SSL-Roots/Circuit_MotorDriverBoard/MotorDriver作成マニュアル.txt

1.裏面のコンデンサと抵抗をはんだ付けします。
2.裏面のICをはんだ付けします。
3.電源ラインの貫通ビアに抵抗の足などを入れてはんだ付けしてください。
　電流容量を稼ぐためです。
4.表面のコンデンサ、抵抗、ダイオード、LEDをはんだ付けします。
5.表面のICをはんだ付けします。
6.裏面のフレキコネクタをはんだ付けします。
7.4ピンコネクタをはんだ付けします。
8.書き込み用L字ピンヘッダをはんだ付けします。
9.細ピンヘッダをはんだ付けします。
