SSL-Roots/Circuit_MotorDriverBoard/MotorDriver運用マニュアル.txt

使用方法
Roots製メイン基板、エンコーダ基板と組み合わせて使用します。
Roots製メイン基板のピンソケットに挿入して使用します。

エンコーダ基板とのピン配置は以下です。
1:+5V
2:A相信号入力
3:GND
4:B相信号入力

注意点
配線時に確実にメイン基板と同名の信号となるよう配線してください。
逆に接続した場合は破壊の危険があります。
メイン基板へ挿入する場合はピンがズレないように気を付けてください。
ピンがズレた状態で電源を投入すると破壊します。

定格
電源電圧:13V～17V
3.3V:3.3V±0.3V
+5V:5V±0.5V

EC45-flat 30Wにのみ対応します。30W以上のモータの場合破壊する可能性があります。
