SSL-Roots/Circuit_MotorDriverBoard/MotorDriver - MotorDriver.pdf

Part | Value | 耐圧・電力 | Package | 購入先 | 単価
C100 | 10u | 25V | C2012 | 秋月電子 | ¥15.00
C101 | 貫通Co 0.1u | - | CKD610JB | 秋月電子 | ¥20.00
C102 | 0.1u | 25V | C1608 | 秋月電子 | ¥2.00
C103 | 未実装(0.047u) | - | C1608 | - | -
C200 | 1u | 50V | C1608 | 秋月電子 | ¥5.00
C201 | 1u | 50V | C1608 | 秋月電子 | ¥5.00
C202 | 1u | 50V | C1608 | 秋月電子 | ¥5.00
C203 | 1u | 50V | C1608 | 秋月電子 | ¥5.00
C204 | 1u | 50V | C1608 | 秋月電子 | ¥5.00
C205 | 1u | 50V | C1608 | 秋月電子 | ¥5.00
C206 | 100u | 25Ｖ | 5mm | 秋月電子 | ¥10.00
CON100 | 細ピンヘッダ6pin | - | 2.54mmピッチ | 秋月電子 | ¥6.00
CON101 | 細ピンヘッダ6pin | - | 2.54mmピッチ | 秋月電子 | ¥6.00
CON200 | WM10943CT | - | WM10943CT | DigiKey | ¥136.70
CON201 | S04B-XASK-1 | - | XA4pinL字 | RS | ¥70.30
D100 | RB751S-40 | - | 1608 | 秋月電子 | ¥4.00
D101 | RB751S-40 | - | 1608 | 秋月電子 | ¥4.00
D102 | RB751S-40 | - | 1608 | 秋月電子 | ¥4.00
IC100 | DSPIC33EP32MC502 | - | SOIC-28 | DigiKey | ¥275.00
IC101 | MCP2551 | - | SOIC-8 | DigiKey | ¥126.00
IC200 | MCP14700 | - | SOIC-8 | DigiKey | ¥184.04
IC201 | MCP14700 | - | SOIC-8 | DigiKey | ¥184.04
IC202 | MCP14700 | - | SOIC-8 | DigiKey | ¥184.04
LED100 | OSHR1608 | - | LEDCHIPLED_1608 | 秋月電子 | ¥10.00
LED101 | OSHR1608 | - | LEDCHIPLED_1608 | 秋月電子 | ¥10.00
LED102 | OSHR1608 | - | LEDCHIPLED_1608 | 秋月電子 | ¥10.00
Q200 | DMG4822SSD | - | SO-8 | RS | ¥27.35
Q201 | DMG4822SSD | - | SO-8 | RS | ¥27.35
Q202 | DMG4822SSD | - | SO-8 | RS | ¥27.35
R100 | 100k | 1/10W | R1608 | 秋月電子 | ¥0.20
R101 | 10k | 1/10W | R1608 | 秋月電子 | ¥0.20
R102 | 1k | 1/10W | R1608 | 秋月電子 | ¥0.20
R103 | 1k | 1/10W | R1608 | 秋月電子 | ¥0.20
R104 | 1k | 1/10W | R1608 | 秋月電子 | ¥0.20
R105 | 未実装(59) | - | R1608 | - | -
R106 | 未実装(59) | - | R1608 | - | -
R107 | 10k | 1/10W | R1608 | 秋月電子 | ¥0.20
R200 | 100 | 1/10W | R1608 | 秋月電子 | ¥0.20
R201 | 100 | 1/10W | R1608 | 秋月電子 | ¥0.20
R202 | 100 | 1/10W | R1608 | 秋月電子 | ¥0.20
R203 | 100 | 1/10W | R1608 | 秋月電子 | ¥0.20
R204 | 100 | 1/10W | R1608 | 秋月電子 | ¥0.20
R205 | 100 | 1/10W | R1608 | 秋月電子 | ¥0.20
VARI100 | AVR-M2012C220KT6AB | - | R2012 | RS | ¥44.20
X3 | 3pin | - | L字ピンヘッダ | 秋月電子 | ¥3.84
基板 | - | - | - | elecrow | ¥262.75
| | | | 合計 | ¥1,686.36
