SSL-Roots/Circuit_MotorDriverBoard/回路図/MotorDriver_FourthEdition_prot.brd

## EAGLE design 回路図/MotorDriver_FourthEdition_prot.brd (2017-08-02)

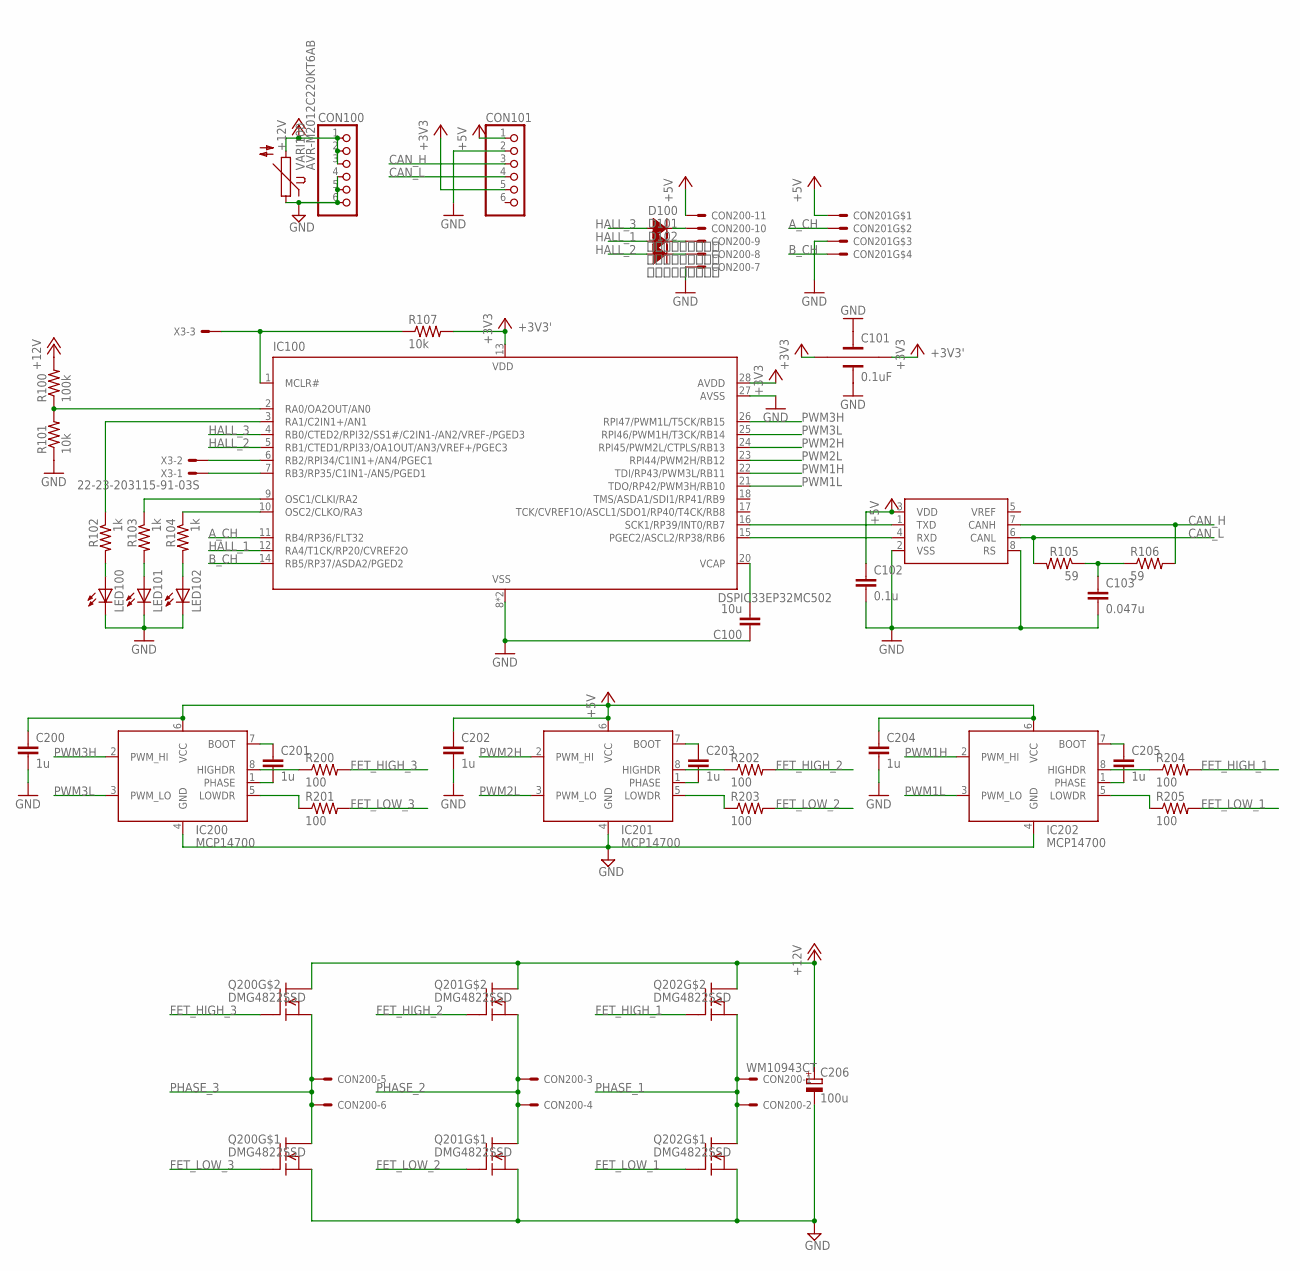
[picture p1: schematic MotorDriver_FourthEdition_prot.sch]

Parts:
C100: 10u; C2012
C101: 0.1uF; CKD610JB
C102: 0.1u; C1608
C103: 0.047u; C1608
C200, C201, C202, C203, C204, C205: 1u; C1608
C206: 100u; E15-5RS
CON100, CON101: PINHD-1X6S; 1X06S
CON200: WM10943CT; 52207-1185
CON201: 4B-XH-AS4B; S4B-XH-A
D100, D101, D102: ＲＢ７５１Ｓ－４０; 1608
IC100: DSPIC33EP32MC502; SOIC-28
IC101: MCP2551; SOIC-8
IC200, IC201, IC202: MCP14700; SOIC-8
LED100, LED101, LED102: LEDCHIPLED_0805; CHIPLED_0805
Q200, Q201, Q202: DMG4822SSD; SO-8
R100: 100k; R1608
R101, R107: 10k; R1608
R102, R103, R104: 1k; R1608
R105, R106: 59; R1608
R200, R201, R202, R203, R204, R205: 100; R1608
VARI100: AVR-M2012C220KT6AB; CT/CN0603
X3: 22-23-203115-91-03S; 15-91-03S

Connections:
+3V3: C101.2 (IN), CON101.5
+3V3': C101.1 (OUT), IC100.13 (VDD), IC100.28 (AVDD), R107.2
+5V: C102.1, C200.1, C202.1, C204.1, CON101.1, CON200.11, CON201.1, IC101.3 (VDD), IC200.6 (VCC), IC201.6 (VCC), IC202.6 (VCC)
+12V: C206.+, CON100.1, CON100.2, CON100.3, Q200.7 (D), Q200.8 (D), Q201.7 (D), Q201.8 (D), Q202.7 (D), Q202.8 (D), R100.2, VARI100.2
AGND: C100.1, C101.3 (GND), C101.4 (GND1), C102.2, C103.2, CON101.2, CON200.7, CON201.3, IC100.8 (VSS), IC100.19 (VSS), IC100.27 (AVSS), IC101.2 (VSS), IC101.8 (RS), LED100.C, LED101.C, LED102.C, R101.1
A_CH: CON201.2, IC100.11 (RB4/RP36/FLT32)
B_CH: CON201.4, IC100.14 (RB5/RP37/ASDA2/PGED2)
CAN_H: CON101.3, IC101.7 (CANH), R106.2
CAN_L: CON101.4, IC101.6 (CANL), R105.2
FET_HIGH_1: Q202.2 (G), R204.2
FET_HIGH_2: Q201.2 (G), R202.2
FET_HIGH_3: Q200.2 (G), R200.2
FET_LOW_1: Q202.4 (G), R205.2
FET_LOW_2: Q201.4 (G), R203.2
FET_LOW_3: Q200.4 (G), R201.2
HALL_1: D101.A, IC100.12 (RA4/T1CK/RP20/CVREF2O)
HALL_2: D102.A, IC100.5 (RB1/CTED1/RPI33/OA1OUT/AN3/VREF+/PGEC3)
HALL_3: D100.A, IC100.4 (RB0/CTED2/RPI32/SS1#/C2IN1-/AN2/VREF-/P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)
unnamed: IC100.1 (MCLR#), R107.1, X3.3
unnamed: C201.1, IC200.7 (BOOT)
unnamed: IC100.3 (RA1/C2IN1+/AN1), R102.1
unnamed: C203.1, IC201.7 (BOOT)
unnamed: IC100.7 (RB3/RP35/C1IN1-/AN5/PGED1), X3.1
unnamed: IC100.2 (RA0/OA2OUT/AN0), R100.1, R101.2
unnamed: C205.1, IC202.7 (BOOT)
unnamed: IC100.6 (RB2/RPI34/C1IN1+/AN4/PGEC1), X3.2
unnamed: C103.1, R105.1, R106.1
unnamed: CON200.10, D100.C
unnamed: CON200.9, D101.C
unnamed: CON200.8, D102.C
unnamed: IC100.16 (SCK1/RP39/INT0/RB7), IC101.1 (TXD)
unnamed: IC100.15 (PGEC2/ASCL2/RP38/RB6), IC101.4 (RXD)
unnamed: IC200.8 (HIGHDR), R200.1
unnamed: IC200.5 (LOWDR), R201.1
unnamed: IC201.8 (HIGHDR), R202.1
unnamed: IC201.5 (LOWDR), R203.1
unnamed: IC100.9 (OSC1/CLKI/RA2), R103.1
unnamed: LED100.A, R102.2
unnamed: IC202.8 (HIGHDR), R204.1
unnamed: IC202.5 (LOWDR), R205.1
unnamed: IC100.10 (OSC2/CLKO/RA3), R104.1
unnamed: C100.2, IC100.20 (VCAP)
unnamed: LED101.A, R103.2
unnamed: LED102.A, R104.2
PGND: C200.2, C202.2, C204.2, C206.-, CON100.4, CON100.5, CON100.6, IC200.4 (GND), IC201.4 (GND), IC202.4 (GND), Q200.3 (S), Q201.3 (S), Q202.3 (S), VARI100.1
PHASE_1: C205.2, CON200.1, CON200.2, IC202.1 (PHASE), Q202.1 (S), Q202.5 (D), Q202.6 (D)
PHASE_2: C203.2, CON200.3, CON200.4, IC201.1 (PHASE), Q201.1 (S), Q201.5 (D), Q201.6 (D)
PHASE_3: C201.2, CON200.5, CON200.6, IC200.1 (PHASE), Q200.1 (S), Q200.5 (D), Q200.6 (D)
PWM1H: IC100.22 (TDI/RP43/PWM3L/RB11), IC202.2 (PWM_HI)
PWM1L: IC100.21 (TDO/RP42/PWM3H/RB10), IC202.3 (PWM_LO)
PWM2H: IC100.24 (RPI45/PWM2L/CTPLS/RB13), IC201.2 (PWM_HI)
PWM2L: IC100.23 (RPI44/PWM2H/RB12), IC201.3 (PWM_LO)
PWM3H: IC100.26 (RPI47/PWM1L/T5CK/RB15), IC200.2 (PWM_HI)
PWM3L: IC100.25 (RPI46/PWM1H/T3CK/RB14), IC200.3 (PWM_LO)

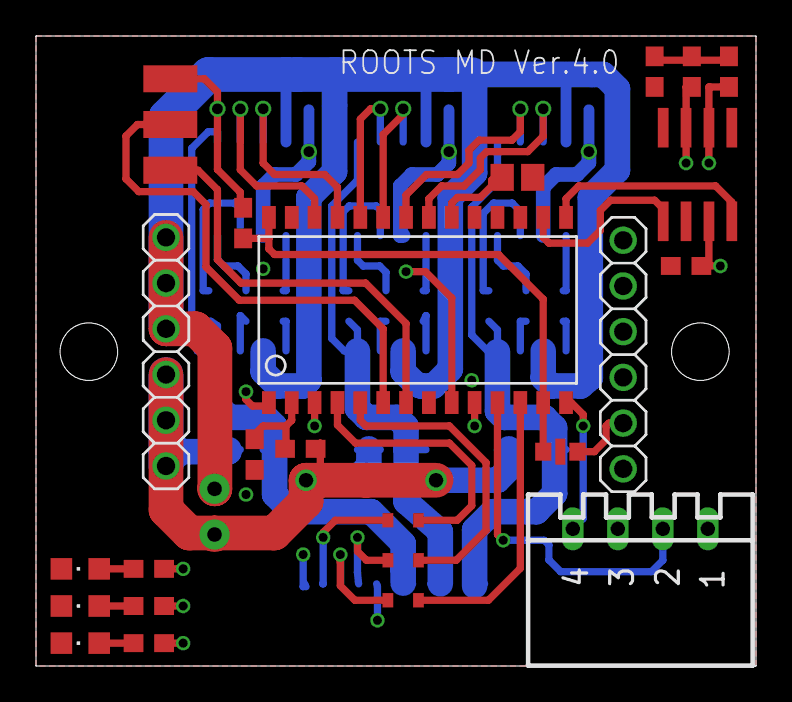
[picture p2: board MotorDriver_FourthEdition_prot.brd from above]

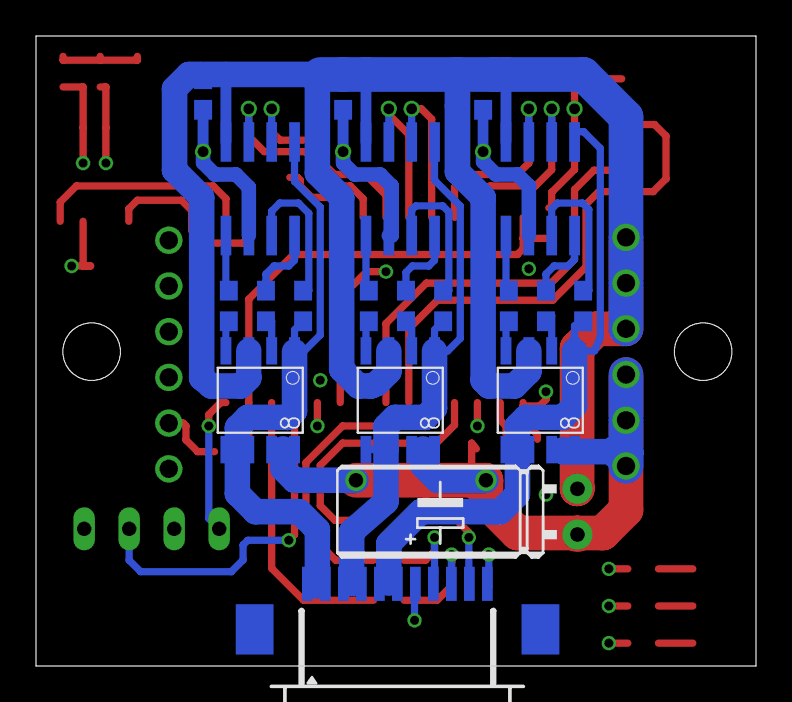
[picture p3: board MotorDriver_FourthEdition_prot.brd from below]

Board: 4 copper layers, 40.0 x 35.0 mm, 45 parts (19 on the bottom side), 54 nets.
